sorphin/Modified_XT-FDC_ForQuadFloppies/isa_fdc.kicad_DB37-v3.1.2_pcb_back.png

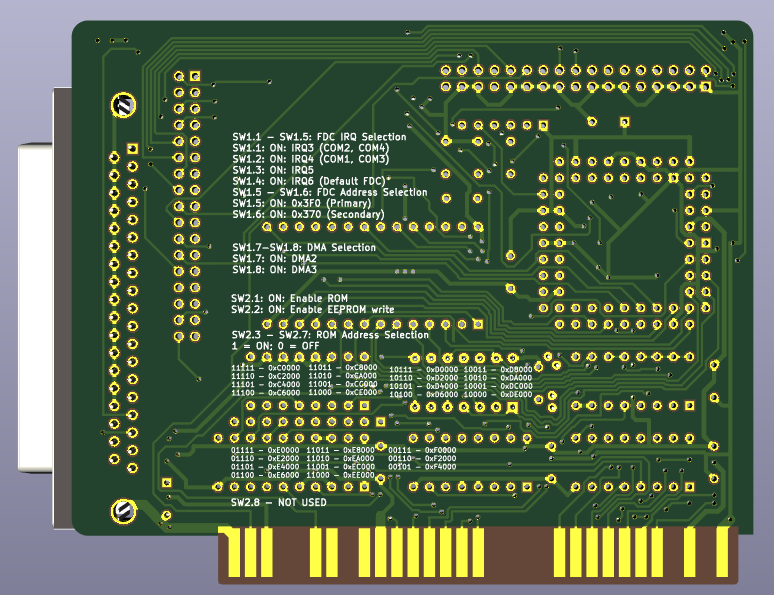
isa_fdc.kicad_DB37-v3.1.2_pcb_back.png
