sorphin/Modified_XT-FDC_ForQuadFloppies/isa_fdc.kicad_DB37-v3.1.2_pcb_front.png

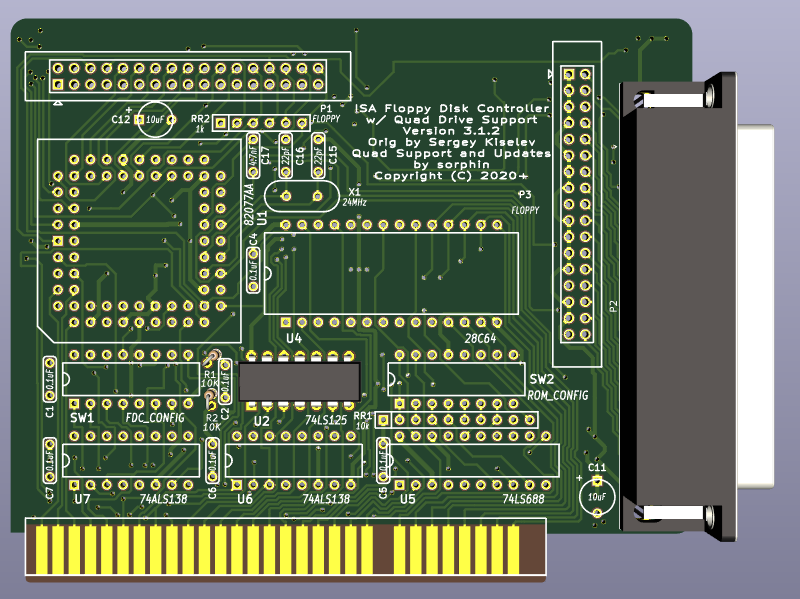
isa_fdc.kicad_DB37-v3.1.2_pcb_front.png
