sorphin/Modified_XT-FDC_ForQuadFloppies/XT_Slot-8_Variant/isa_fdc.kicad_DB37-v3.2.1.1_pcb._front.png

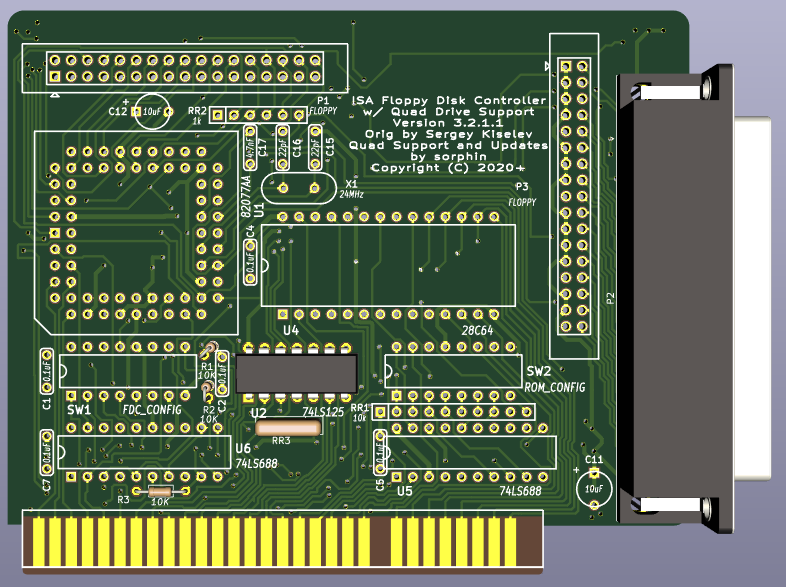
XT_Slot-8_Variant/isa_fdc.kicad_DB37-v3.2.1.1_pcb._front.png
