sorphin/Modified_XT-FDC_ForQuadFloppies/XT_Slot-8_Variant/isa_fdc.kicad_DB37-v3.2.1.1_pcb_back.png

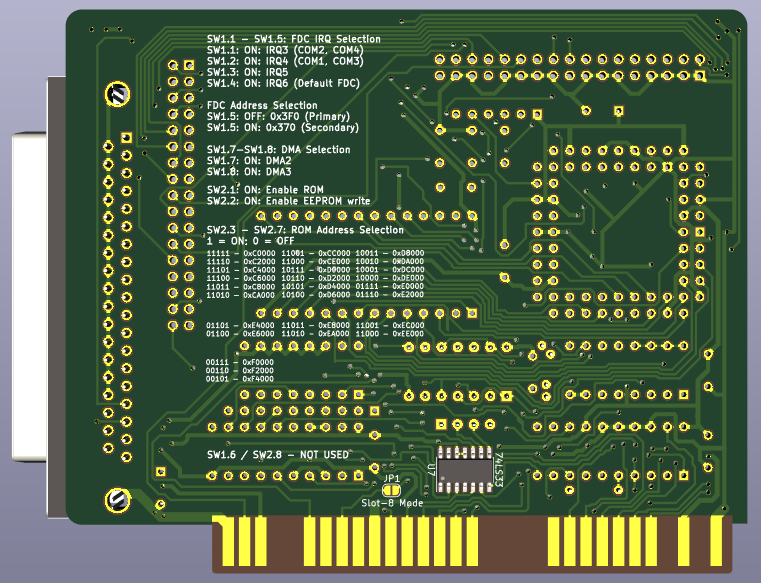
XT_Slot-8_Variant/isa_fdc.kicad_DB37-v3.2.1.1_pcb_back.png
