sorphin/Modified_XT-FDC_ForQuadFloppies/isa_fdc.kicad_DB37-v3.1.2_pcb.pdf

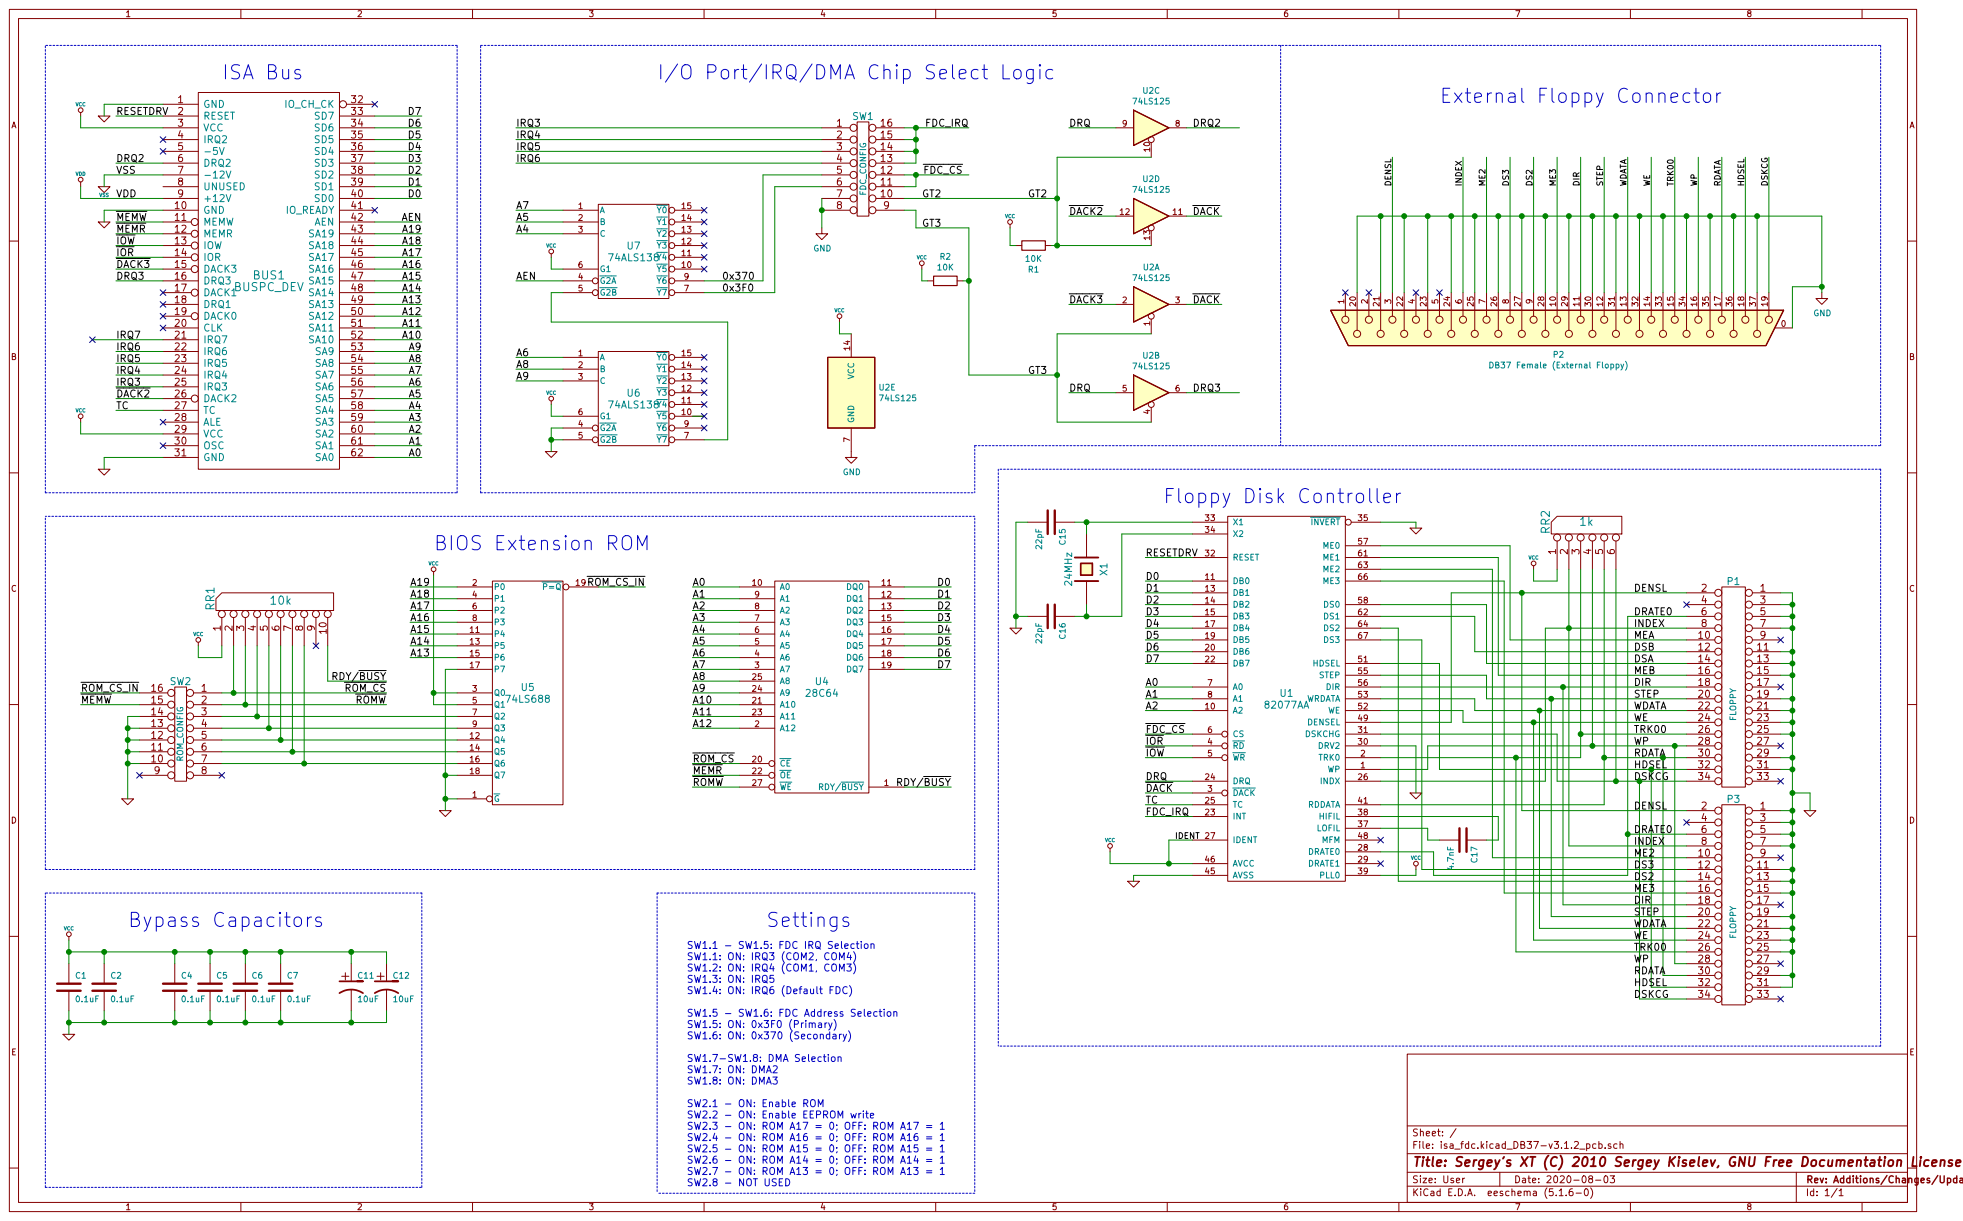
[picture p5: page 1]

I/O Port/IRQ/DMA Chip Select Logic

12022132242352462572682792810291130123113321433153416351736183719 P2 DB37 Female (External Floppy) RDY/BUSY 1 A0 10 DQ0 11 DQ1 12 DQ2 13 DQ3 15 DQ4 16 DQ5 17 DQ6 18 DQ7 19 A12 2 CE 20 A10 21 OE 22 A11 23 A9 24 A8 25 WE 27 A7 3 A6 4 A5 5 A4 6 A3 7 A2 8 A1 9 U4

14 | | 13
16 | | 15
18 | | 17 19
20
22 | | 21
24 | | 23
26 | | 25
28 | | | | 27 29

TRK00 WP RDATA RDY/BUSY

10 | 11

14 | 13
16 | 15

SW2.1 - ON: Enable ROM
SW2.2 - ON: Enable EEPROM write
SW2.3 - ON: ROM A17 = 0; OFF: ROM A17 = 1
SW2.4 - ON: ROM A16 = 0; OFF: ROM A16 = 1
SW2.5 - ON: ROM A15 = 0; OFF: ROM A15 = 1
SW2.6 - ON: ROM A14 = 0; OFF: ROM A14 = 1
SW2.7 - ON: ROM A13 = 0; OFF: ROM A13 = 1
SW2.8 - NOT USED

Id: 1/1 Title: Sergey's XT (C) 2010 Sergey Kiselev, GNU Free Documentation License (GFDL)
