sorphin/Modified_XT-FDC_ForQuadFloppies/XT_Slot-8_Variant/isa_fdc.kicad_DB37-v3.2.1.1_pcb.pdf

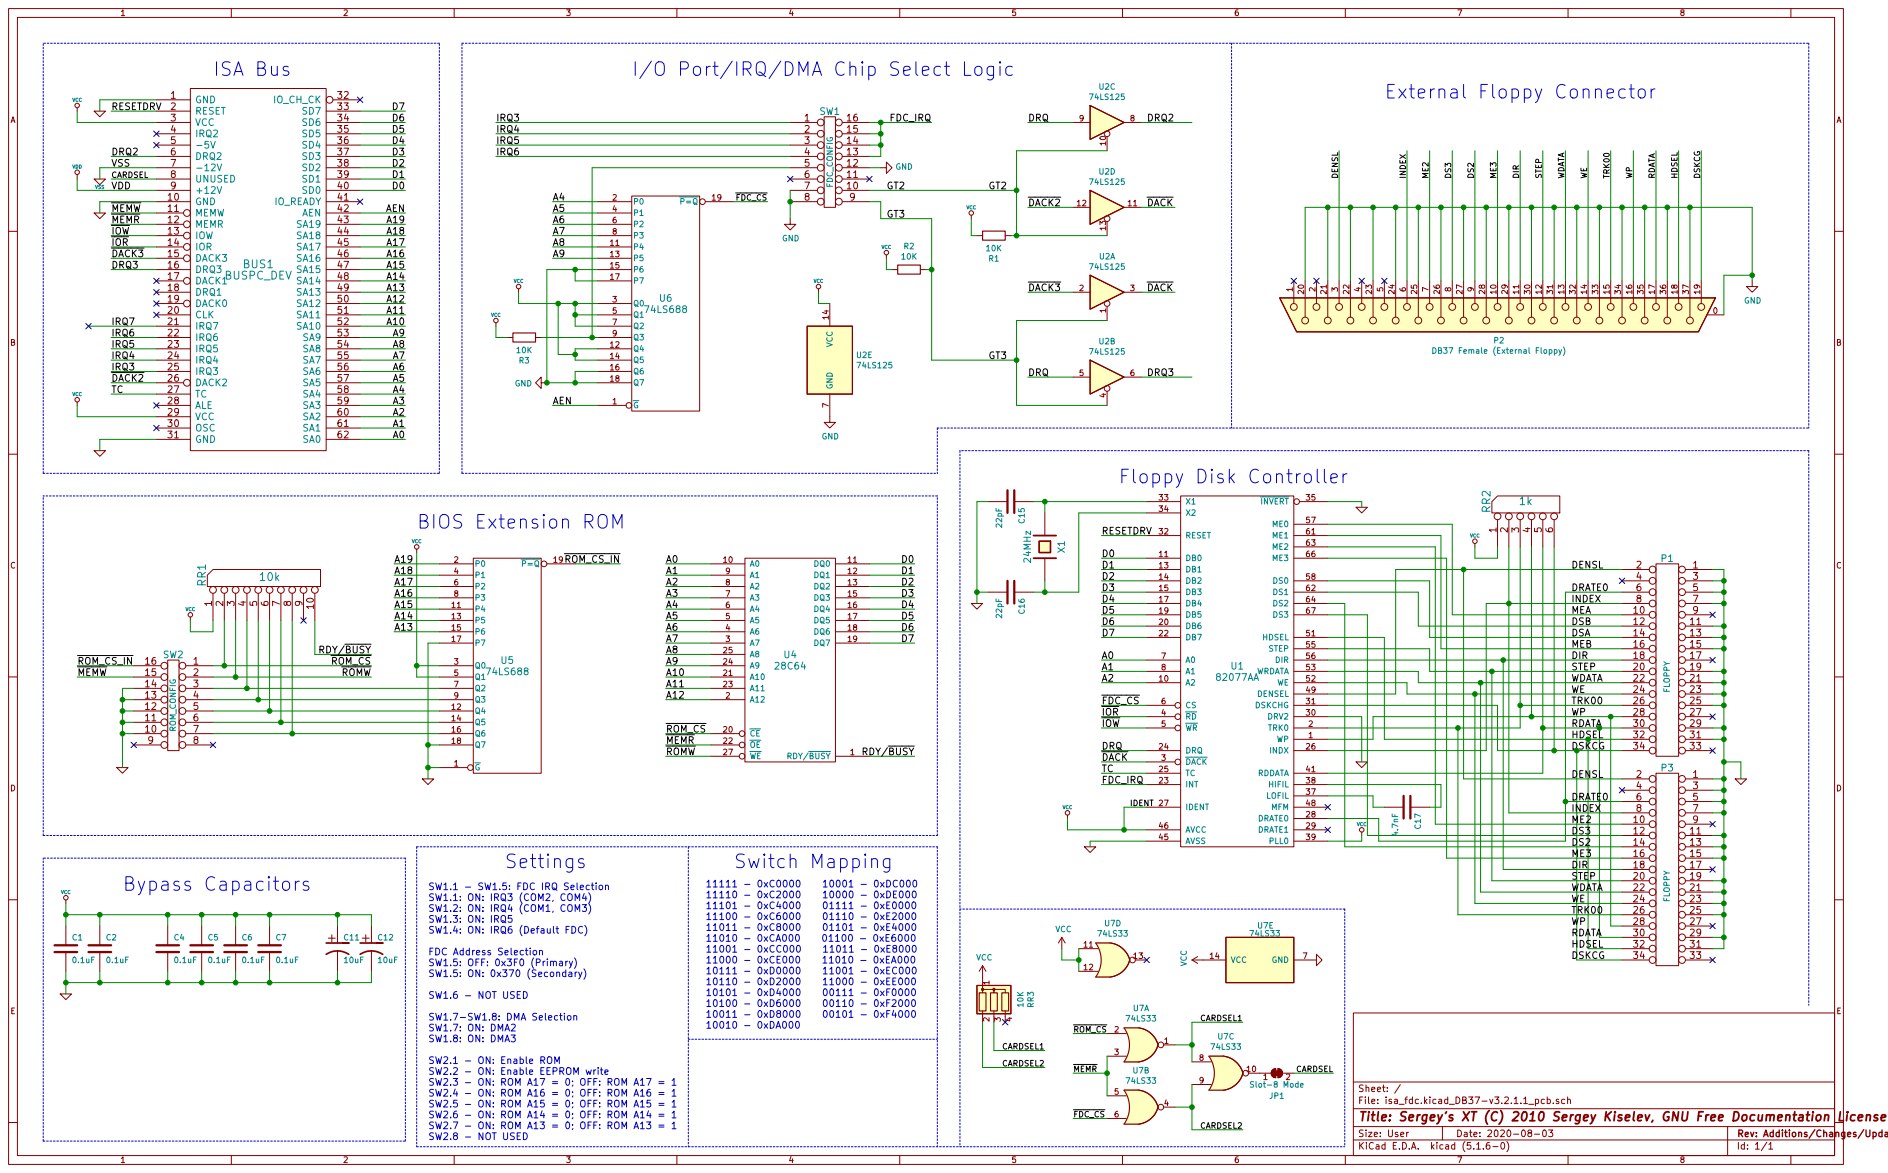
[picture p6: page 1]

I/O Port/IRQ/DMA Chip Select Logic
FDC_CS ROM_CS

12022132242352462572682792810291130123113321433153416351736183719 P2 DB37 Female (External Floppy) VCC R2

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

FDC_IRQ

10 | 11
12
14 | 13

18 | 17 19
22 | 21
24 | 23
26 | 25

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

Id: 1/1 Title: Sergey's XT (C) 2010 Sergey Kiselev, GNU Free Documentation License (GFDL)
