sorphin/Modified_XT-FDC_ForQuadFloppies/isa_fdc.kicad_DB37-v3.1.2_pcb.kicad_pcb

## KiCad design isa_fdc.kicad_DB37-v3.1.2_pcb.kicad_pcb (2020-08-23)

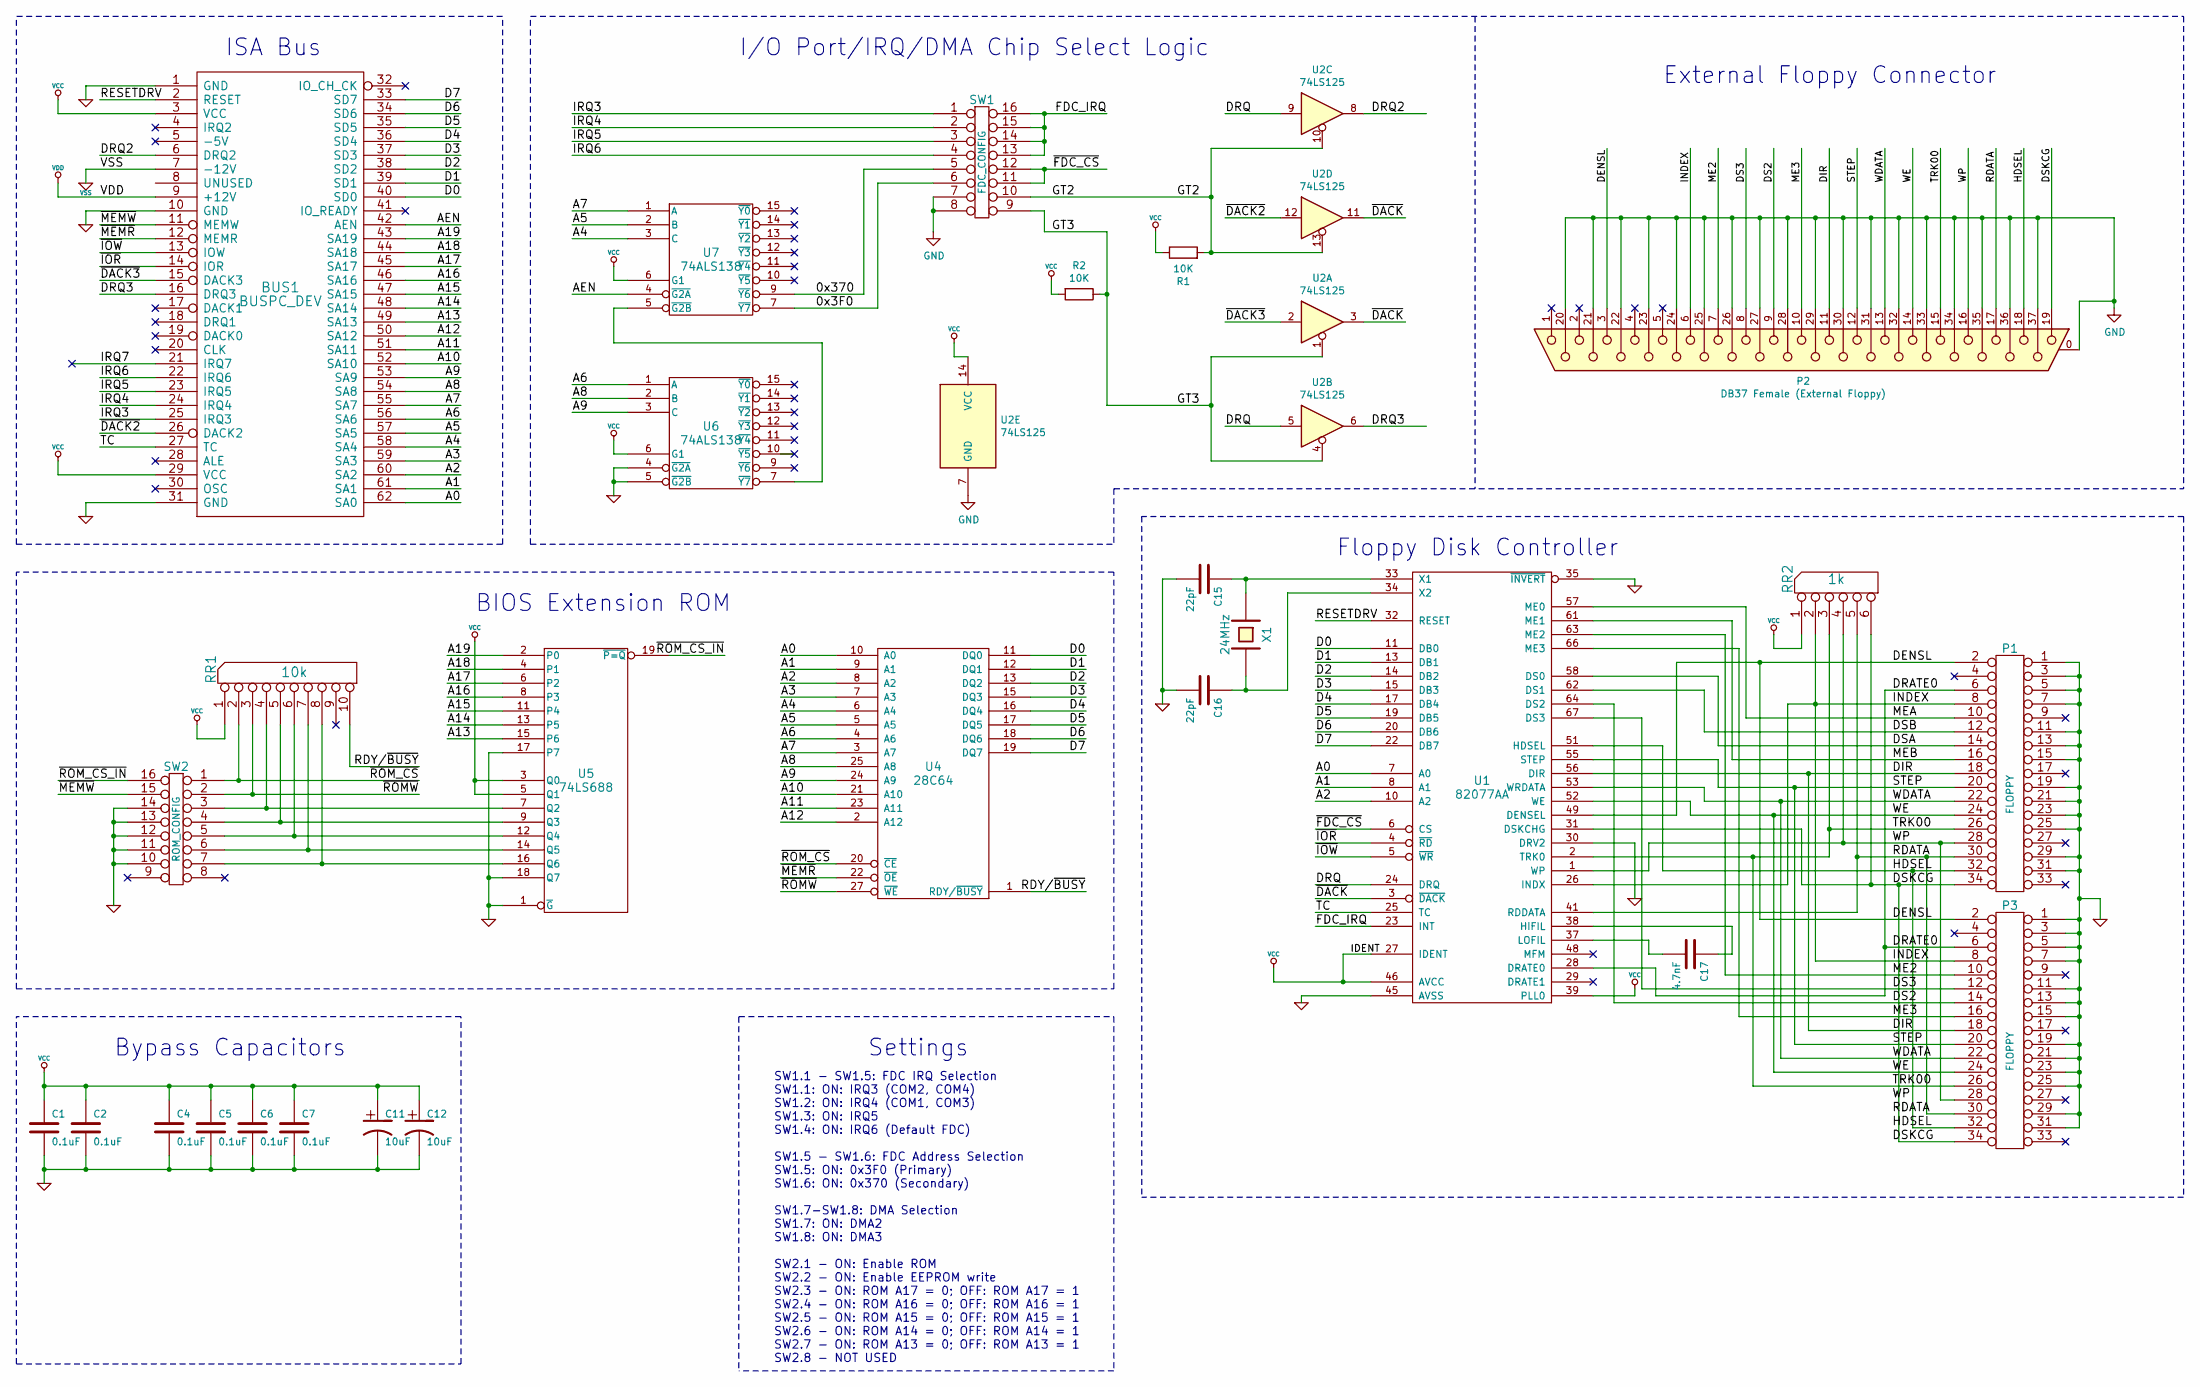
[picture p7: schematic isa_fdc.kicad_DB37-v3.1.2_pcb.sch, Sergey's XT (C) 2010 Sergey Kiselev, GNU Free Documentation…]

Parts:
BUS1: BUSPC_DEV
C1, C2, C4, C5, C6, C7: 0.1uF
C11, C12: 10uF
C15, C16: 22pF
C17: 4.7nF
P1, P3: FLOPPY
P2: DB37 Female (External Floppy)
R1, R2: 10K
RR1: 10k
RR2: 1k
SW1: FDC_CONFIG
SW2: ROM_CONFIG
U1: 82077AA
U2: 74LS125
U4: 28C64
U5: 74LS688
U6, U7: 74ALS138
X1: 24MHz

Connections:
/A0: BUS1.62 (SA0), U1.7 (A0), U4.10 (A0)
/A1: BUS1.61 (SA1), U1.8 (A1), U4.9 (A1)
/A2: BUS1.60 (SA2), U1.10 (A2), U4.8 (A2)
/A3: BUS1.59 (SA3), U4.7 (A3)
/A4: BUS1.58 (SA4), U4.6 (A4), U7.3 (C)
/A5: BUS1.57 (SA5), U4.5 (A5), U7.2 (B)
/A6: BUS1.56 (SA6), U4.4 (A6), U6.1 (A)
/A7: BUS1.55 (SA7), U4.3 (A7), U7.1 (A)
/A8: BUS1.54 (SA8), U4.25 (A8), U6.2 (B)
/A9: BUS1.53 (SA9), U4.24 (A9), U6.3 (C)
/A10: BUS1.52 (SA10), U4.21 (A10)
/A11: BUS1.51 (SA11), U4.23 (A11)
/A12: BUS1.50 (SA12), U4.2 (A12)
/A13: BUS1.49 (SA13), U5.15 (P6)
/A14: BUS1.48 (SA14), U5.13 (P5)
/A15: BUS1.47 (SA15), U5.11 (P4)
/A16: BUS1.46 (SA16), U5.8 (P3)
/A17: BUS1.45 (SA17), U5.6 (P2)
/A18: BUS1.44 (SA18), U5.4 (P1)
/A19: BUS1.43 (SA19), U5.2 (P0)
/AEN: BUS1.42 (AEN), U7.4 (~G2A)
/D0: BUS1.40 (SD0), U1.11 (DB0), U4.11 (DQ0)
/D1: BUS1.39 (SD1), U1.13 (DB1), U4.12 (DQ1)
/D2: BUS1.38 (SD2), U1.14 (DB2), U4.13 (DQ2)
/D3: BUS1.37 (SD3), U1.15 (DB3), U4.15 (DQ3)
/D4: BUS1.36 (SD4), U1.17 (DB4), U4.16 (DQ4)
/D5: BUS1.35 (SD5), U1.19 (DB5), U4.17 (DQ5)
/D6: BUS1.34 (SD6), U1.20 (DB6), U4.18 (DQ6)
/D7: BUS1.33 (SD7), U1.22 (DB7), U4.19 (DQ7)
/DENSL: P1.2, P2.3, P3.2, U1.49 (DENSEL)
/DIR: P1.18, P2.11, P3.18, U1.56 (DIR)
/DRATE0: P1.6, P3.6, U1.28 (DRATE0)
/DRQ: U1.24 (DRQ), U2.5, U2.9
/DRQ2: BUS1.6 (DRQ2), U2.8
/DRQ3: BUS1.16 (DRQ3), U2.6
/DS2: P2.9, P3.14, U1.64 (DS2)
/DS3: P2.8, P3.12, U1.67 (DS3)
/DSA: P1.14, U1.58 (DS0)
/DSB: P1.12, U1.62 (DS1)
/DSKCG: P1.34, P2.19, P3.34, RR2.6, U1.31 (DSKCHG)
/FDC_IRQ: SW1.13, SW1.14, SW1.15, SW1.16, U1.23 (INT)
/GT2: R1.2, SW1.10, U2.10, U2.13
/GT3: R2.1, SW1.9, U2.1, U2.4
/HDSEL: P1.32, P2.18, P3.32, U1.51 (HDSEL)
/INDEX: P1.8, P2.6, P3.8, RR2.2, U1.26 (INDX)
/IRQ3: BUS1.25 (IRQ3), SW1.1
/IRQ4: BUS1.24 (IRQ4), SW1.2
/IRQ5: BUS1.23 (IRQ5), SW1.3
/IRQ6: BUS1.22 (IRQ6), SW1.4
/IRQ7: BUS1.21 (IRQ7)
/ME2: P2.7, P3.10, U1.63 (ME2)
/ME3: P2.10, P3.16, U1.66 (ME3)
/MEA: P1.10, U1.57 (ME0)
/MEB: P1.16, U1.61 (ME1)
/RDATA: P1.30, P2.17, P3.30, RR2.5, U1.41 (RDDATA)
/RDY/~BUSY: RR1.10, U4.1 (RDY/~BUSY)
/RESETDRV: BUS1.2 (RESET), U1.32 (RESET)
/STEP: P1.20, P2.12, P3.20, U1.55 (STEP)
/TC: BUS1.27 (TC), U1.25 (TC)
/TRK00: P1.26, P2.15, P3.26, RR2.3, U1.2 (TRK0)
/WDATA: P1.22, P2.13, P3.22, U1.53 (WRDATA)
/WE: P1.24, P2.14, P3.24, U1.52 (WE)
/WP: P1.28, P2.16, P3.28, RR2.4, U1.1 (WP)
/~DACK: U1.3 (~DACK), U2.3, U2.11
/~DACK2: BUS1.26 (DACK2), U2.12
/~DACK3: BUS1.15 (DACK3), U2.2
/~FDC_CS: SW1.11, SW1.12, U1.6 (CS)
/~IOR: BUS1.14 (IOR), U1.4 (~RD)
/~IOW: BUS1.13 (IOW), U1.5 (~WR)
/~MEMR: BUS1.12 (MEMR), U4.22 (~OE)
/~MEMW: BUS1.11 (MEMW), SW2.15
/~ROMW: RR1.3, SW2.2, U4.27 (~WE)
/~ROM_CS: RR1.2, SW2.1, U4.20 (~CE)
/~ROM_CS_IN: SW2.16, U5.19 (~P=Q)
GND: BUS1.1 (GND), BUS1.10 (GND), BUS1.31 (GND), C1.2, C2.2, C4.2, C5.2, C6.2, C7.2, C11.2, C12.2, C15.2, C16.2, P1.1, P1.3, P1.5, P1.7, P1.11, P1.13, P1.15, P1.19, P1.21, P1.23, P1.25, P1.29, P1.31, P2.0 (PAD), P2.20, P2.21, P2.22, P2.23, P2.24, P2.25, P2.26, P2.27, P2.28, P2.29, P2.30, P2.31, P2.32, P2.33, P2.34, P2.35, P2.36, P2.37, P3.1, P3.3, P3.5, P3.7, P3.11, P3.13, P3.15, P3.19, P3.21, P3.23, P3.25, P3.29, P3.31, SW1.7, SW1.8, SW2.10, SW2.11, SW2.12, SW2.13, SW2.14, U1.9 (GND), U1.12 (GND), U1.16 (GND), U1.21 (GND), U1.30 (DRV2), U1.35 (~INVERT), U1.36 (GND), U1.45 (AVSS), U1.50 (GND), U1.54 (GND), U1.59 (GND), U1.65 (GND), U2.7 (GND), U4.14 (GND), U5.1 (~G), U5.10 (GND), U5.17 (P7), U5.18 (Q7), U6.4 (~G2A), U6.5 (~G2B), U6.8 (GND), U7.8 (GND)
unnamed: C15.1, U1.33 (X1), X1.1
unnamed: C16.1, U1.34 (X2), X1.2
unnamed: C17.1, U1.38 (HIFIL)
unnamed: C17.2, U1.37 (LOFIL)
unnamed: RR1.4, SW2.3, U5.7 (Q2)
unnamed: RR1.5, SW2.4, U5.9 (Q3)
unnamed: RR1.6, SW2.5, U5.12 (Q4)
unnamed: RR1.7, SW2.6, U5.14 (Q5)
unnamed: RR1.8, SW2.7, U5.16 (Q6)
unnamed: U6.7 (~Y7), U7.5 (~G2B)
VCC: BUS1.3 (VCC), BUS1.29 (VCC), C1.1, C2.1, C4.1, C5.1, C6.1, C7.1, C11.1, C12.1, R1.1, R2.2, RR1.1 (COM), RR2.1 (COM), U1.18 (VCC), U1.27 (IDENT), U1.39 (PLL0), U1.40 (VCC), U1.46 (AVCC), U1.60 (VCC), U1.68 (VCC), U2.14 (VCC), U4.28 (VCC), U5.3 (Q0), U5.5 (Q1), U5.20 (VCC), U6.6 (G1), U6.16 (VCC), U7.6 (G1), U7.16 (VCC)
VDD: BUS1.9 (+12V)
VSS: BUS1.7 (-12V)

Notes on the sheet:
ISA Bus
BIOS Extension ROM
Bypass Capacitors
I/O Port/IRQ/DMA Chip Select Logic
Floppy Disk Controller
Settings
SW1.1 - SW1.5: FDC IRQ Selection SW1.1: ON: IRQ3 (COM2, COM4) SW1.2: ON: IRQ4 (COM1, COM3) SW1.3: ON: IRQ5 SW1.4: ON: IRQ6 (Default FDC) SW1.5 - SW1.6: FDC Address Selection SW1.5: ON: 0x3F0 (Primary) SW1.6: ON: 0x370 (Secondary) SW1.7-SW1.8: DMA Selection SW1.7: ON: DMA2 SW1.8: ON: DMA3 SW2.1 - ON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
External Floppy Connector

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
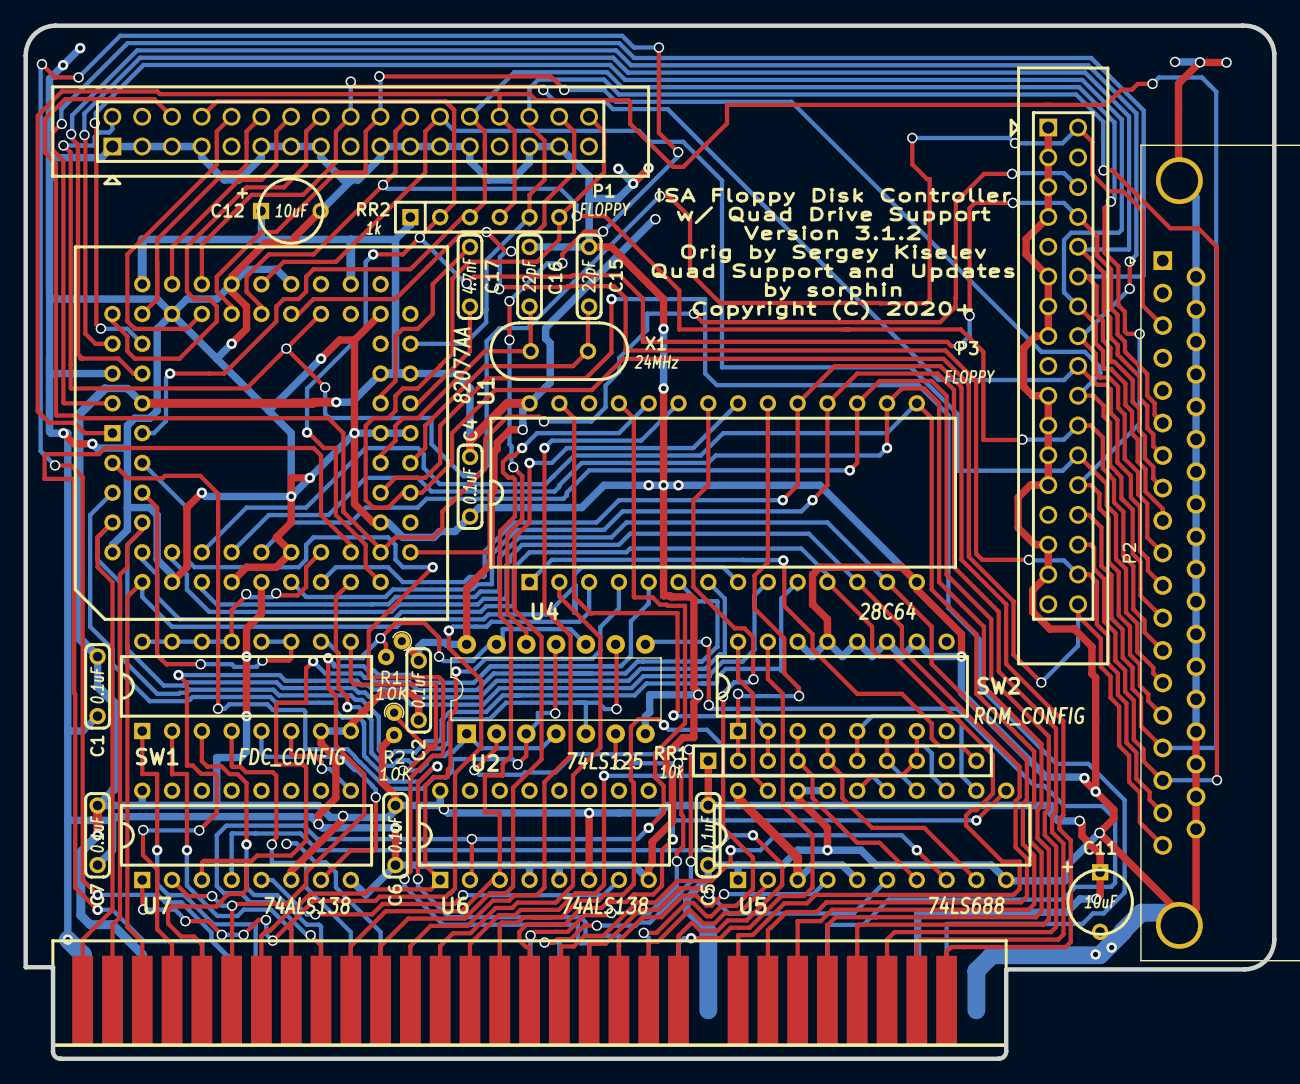
[picture p8: board isa_fdc.kicad_DB37-v3.1.2_pcb.kicad_pcb from above]

Board: 2 copper layers, 106.5 x 88.1 mm, 28 parts (0 on the bottom side), 87 nets.
