sorphin/Modified_XT-FDC_ForQuadFloppies/(notices)

Notices in the files:
isa_fdc.kicad_DB37-v3.1.2_pcb.kicad_pcb:
Copyright (C) 2020+
